robbertvdzon/pepernotenmachine/launcher/3d/trigger/pepernoten_bakje_inlaad_omhulsel.stl

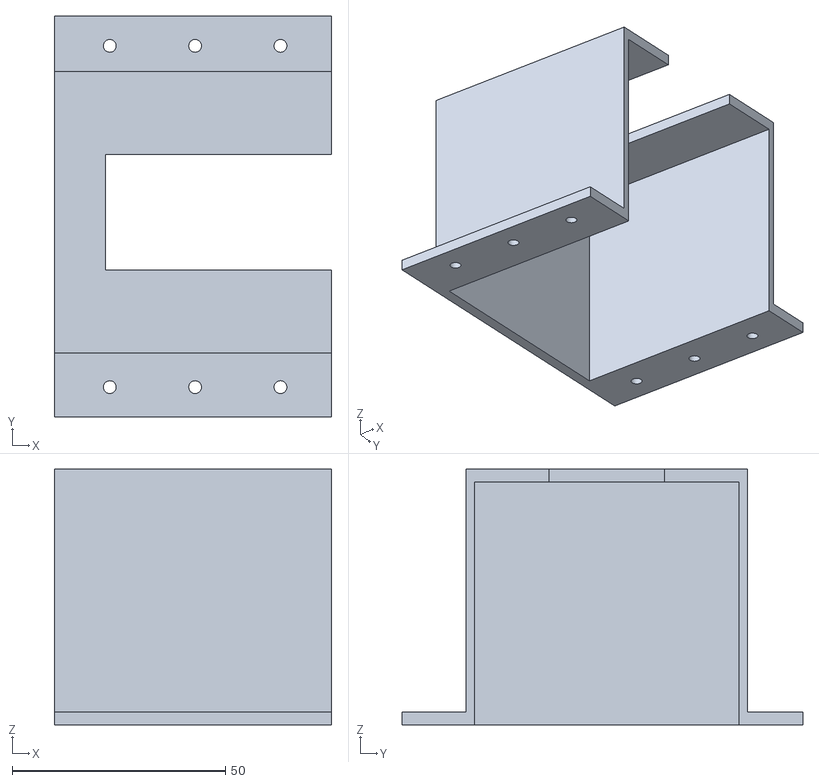
[picture p1: CAD file, 2026-10-23]
launcher/3d/trigger/pepernoten_bakje_inlaad_omhulsel.stl
65.0 x 94.0 x 60.0
