robbertvdzon/pepernotenmachine/launcher/3d/vulbak/klep_aansluiting.stl

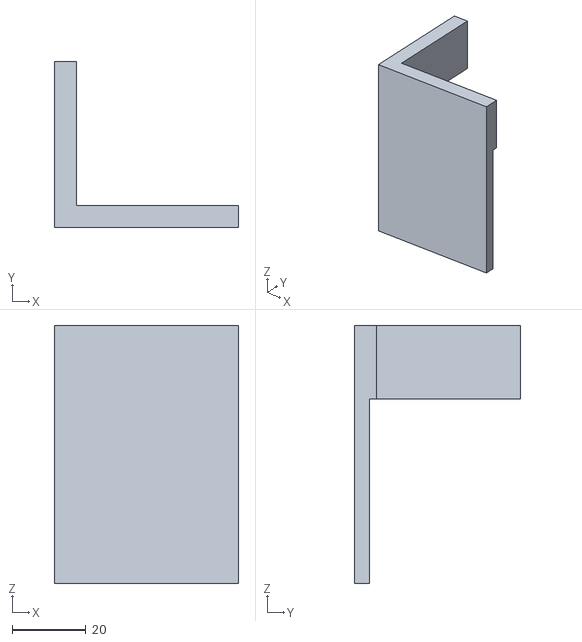
[picture p2: CAD file, 2026-10-23]
launcher/3d/vulbak/klep_aansluiting.stl
50.0 x 45.0 x 70.0
