robbertvdzon/pepernotenmachine/launcher/3d/vulbak2/balkje_op_klep.stl

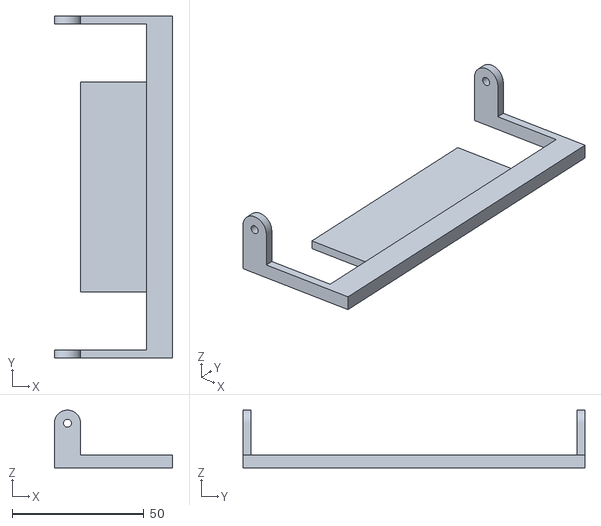
[picture p3: CAD file, 2026-10-23]
launcher/3d/vulbak2/balkje_op_klep.stl
45.0 x 130.0 x 22.0
