robbertvdzon/pepernotenmachine/motorhouder/pepernoten_motorhouder_achterkant_v2.stl

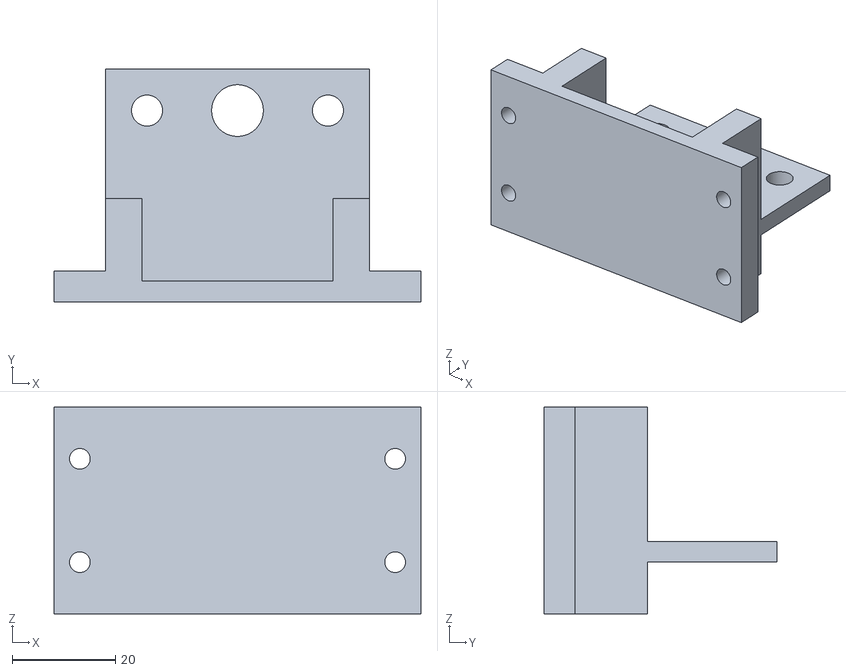
[picture p4: CAD file, 2026-10-11]
motorhouder/pepernoten_motorhouder_achterkant_v2.stl
71.0 x 45.0 x 40.0
