robbertvdzon/pepernotenmachine/launcher/3d/trigger/pepernoten_veer_houder2.stl

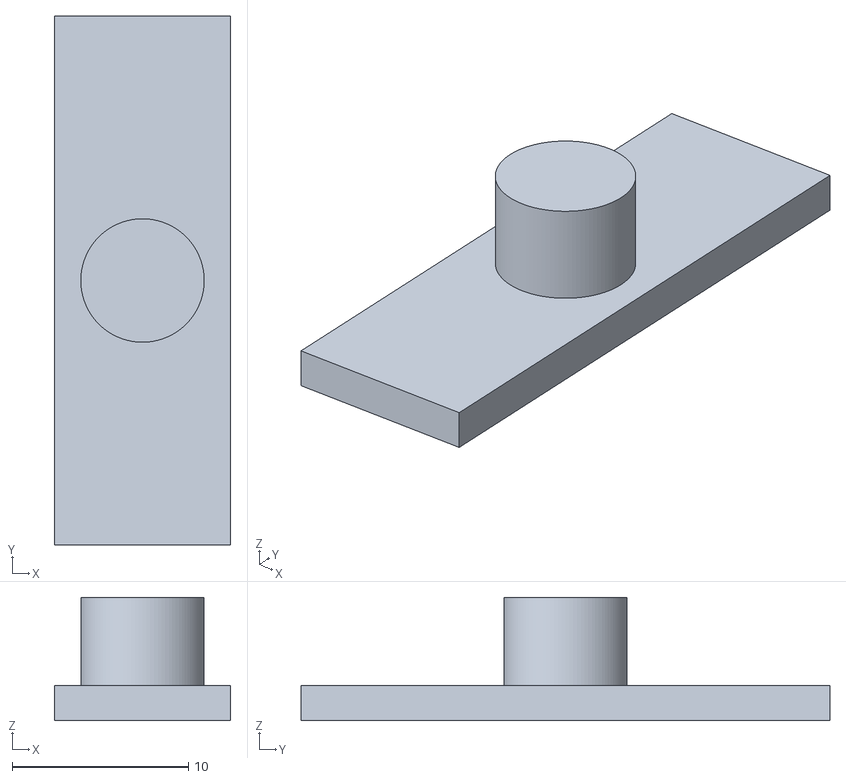
[picture p5: CAD file, 2026-09-05]
launcher/3d/trigger/pepernoten_veer_houder2.stl
10.0 x 30.0 x 7.00
