robbertvdzon/pepernotenmachine/launcher/3d/vulbak/servo_aansluiting.stl

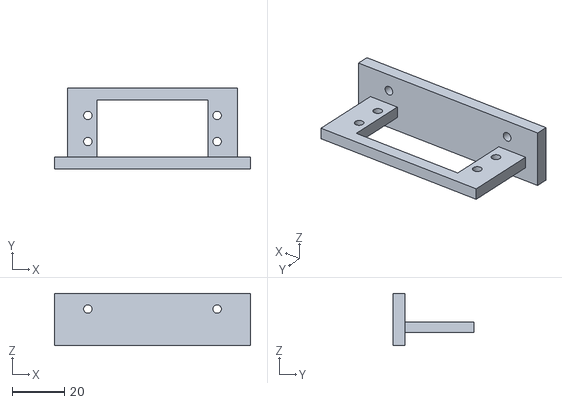
[picture p6: CAD file, 2026-10-23]
launcher/3d/vulbak/servo_aansluiting.stl
75.0 x 31.0 x 20.0
