robbertvdzon/pepernotenmachine/launcher/3d/vulbak2/trechter.stl

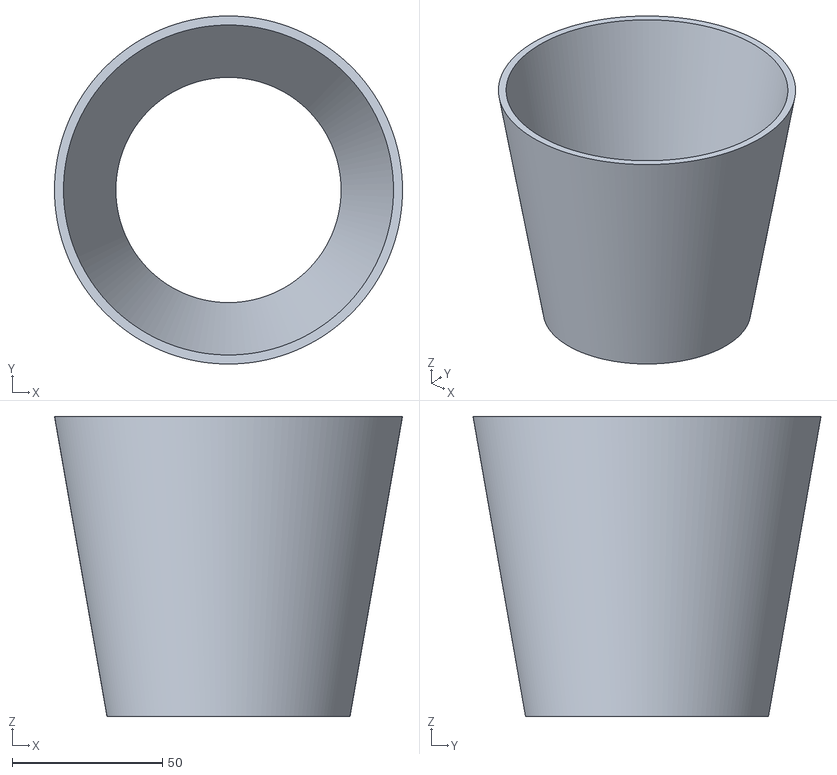
[picture p7: CAD file, 2026-10-23]
launcher/3d/vulbak2/trechter.stl
116.0 x 116.0 x 100.0
