robbertvdzon/pepernotenmachine/motorhouder/pepernoten_motoras-deksel-bovenkant.stl

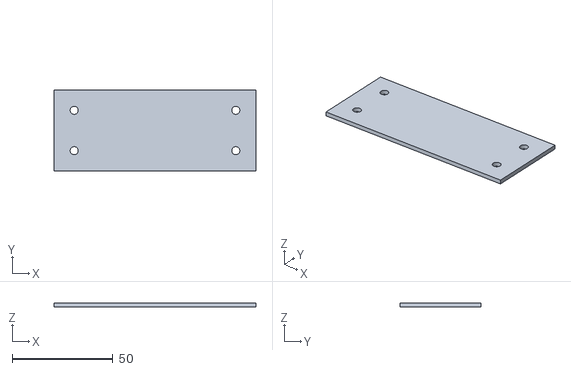
[picture p8: CAD file, 2026-09-29]
motorhouder/pepernoten_motoras-deksel-bovenkant.stl
100.0 x 40.0 x 2.00
