robbertvdzon/pepernotenmachine/launcher/3d/trigger/pepernoten_bakje_schuiver.stl

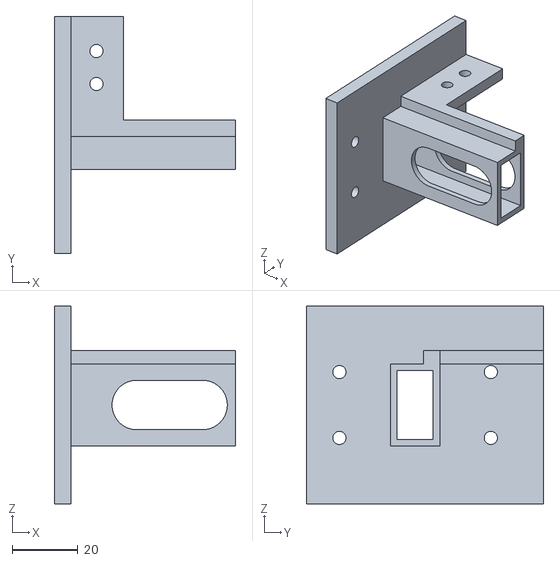
[picture p9: CAD file, 2026-09-05]
launcher/3d/trigger/pepernoten_bakje_schuiver.stl
55.0 x 72.0 x 60.0
