robbertvdzon/pepernotenmachine/motorhouder/pepernoten_motoras-deksel.stl

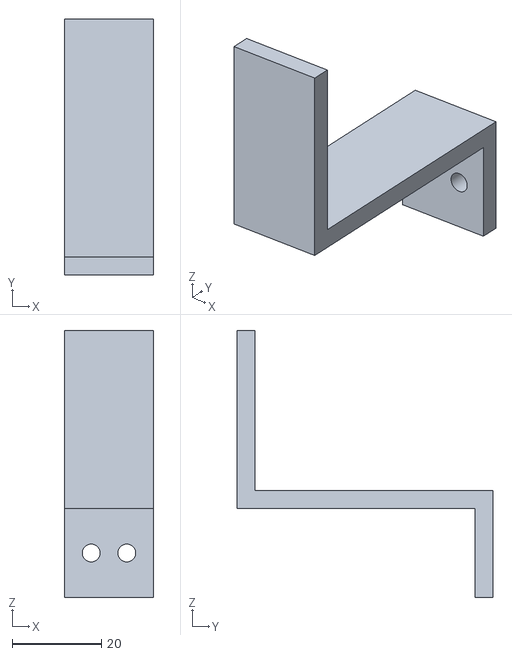
[picture p10: CAD file, 2026-09-29]
motorhouder/pepernoten_motoras-deksel.stl
20.0 x 57.5 x 60.0
