robbertvdzon/pepernotenmachine/launcher/3d/trigger/pepernoten_schakelaar_houder.stl

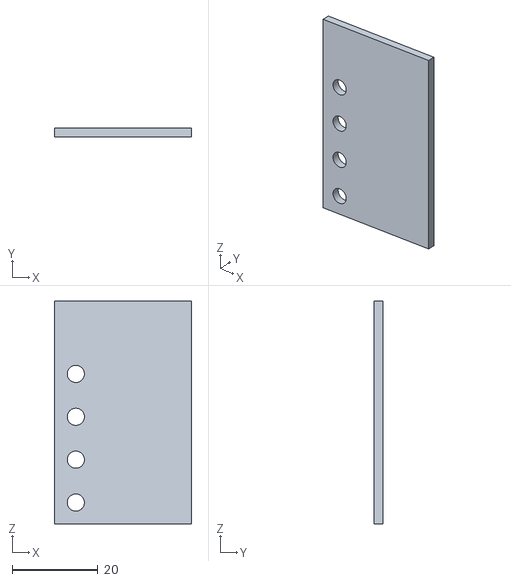
[picture p11: CAD file, 2026-09-05]
launcher/3d/trigger/pepernoten_schakelaar_houder.stl
32.0 x 2.00 x 52.0
