robbertvdzon/pepernotenmachine/launcher/3d/trigger/pepernoten_steun.stl

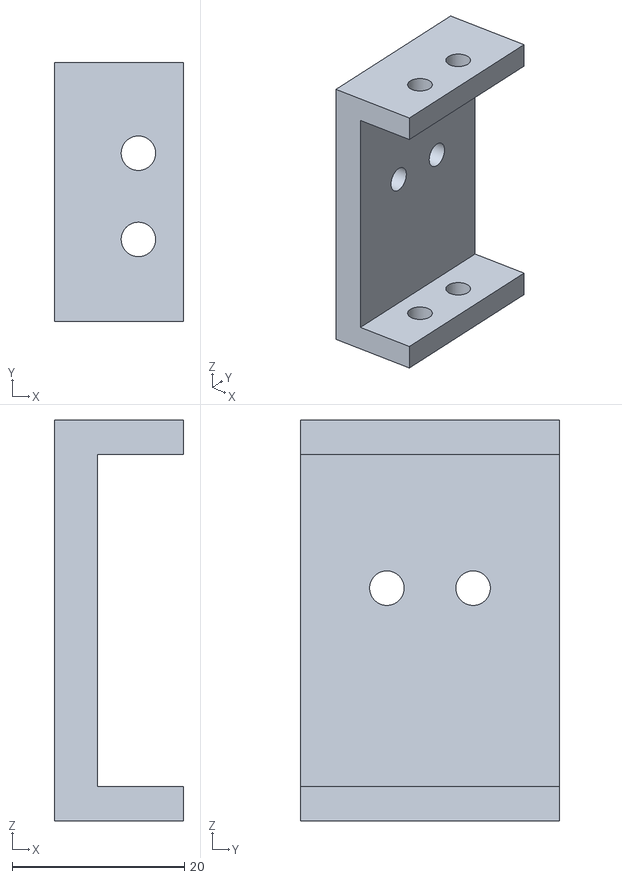
[picture p12: CAD file, 2026-09-05]
launcher/3d/trigger/pepernoten_steun.stl
15.0 x 30.0 x 46.5
