robbertvdzon/pepernotenmachine/motorhouder/pepernoten_motorhouder.stl

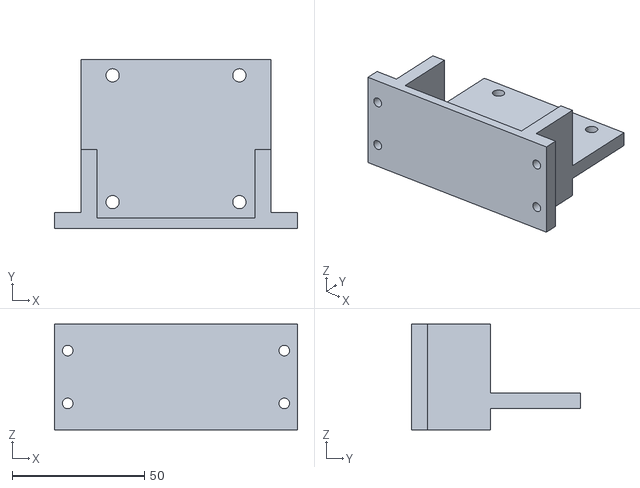
[picture p13: CAD file, 2026-09-29]
motorhouder/pepernoten_motorhouder.stl
92.0 x 64.0 x 40.0
