robbertvdzon/pepernotenmachine/launcher/3d/trigger/pepernoten_servo_aansluiting.stl

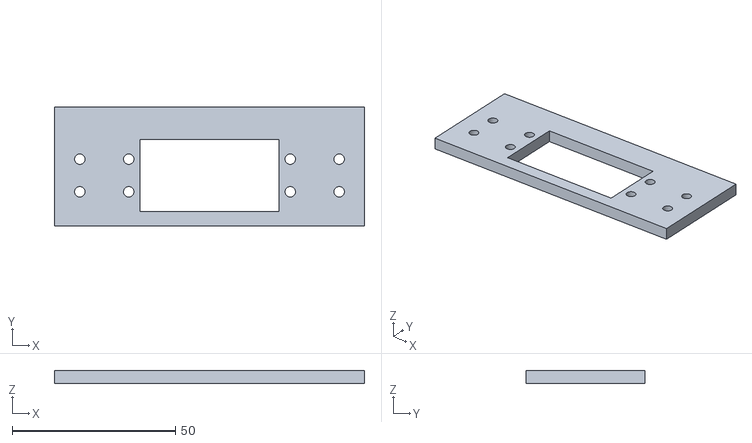
[picture p14: CAD file, 2026-09-05]
launcher/3d/trigger/pepernoten_servo_aansluiting.stl
95.0 x 36.5 x 4.00
