robbertvdzon/pepernotenmachine/motorhouder/pepernoten_motorhouder_ring.stl

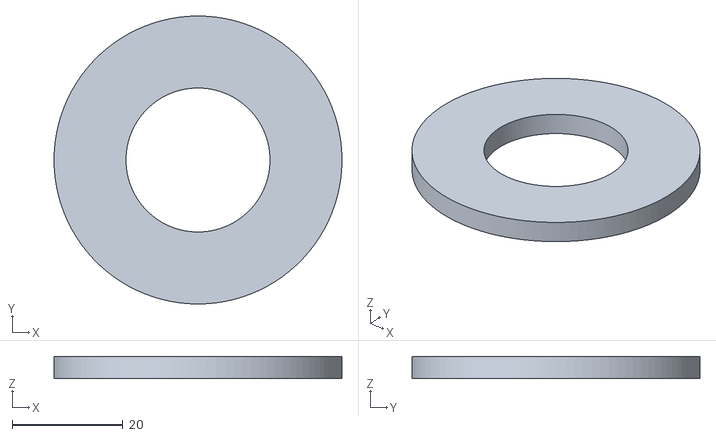
[picture p15: CAD file, 2026-09-25]
motorhouder/pepernoten_motorhouder_ring.stl
52.0 x 52.0 x 4.00
