robbertvdzon/pepernotenmachine/launcher/3d/trigger/pepernoten_veer_houder.stl

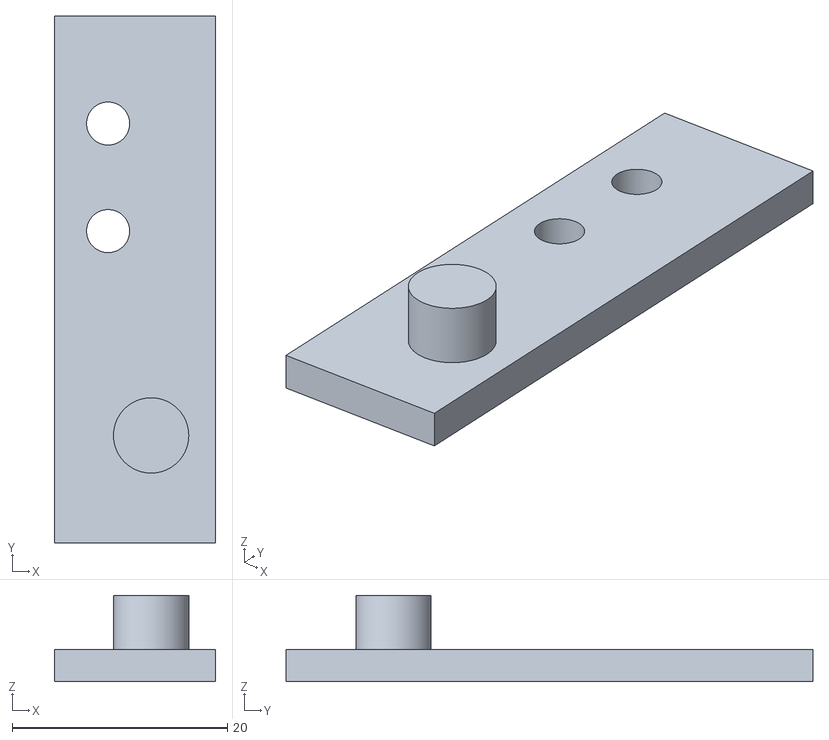
[picture p16: CAD file, 2026-09-05]
launcher/3d/trigger/pepernoten_veer_houder.stl
15.0 x 49.0 x 8.00
