robbertvdzon/pepernotenmachine/motorhouder/pepernoten_motorhouder_v2.3mf

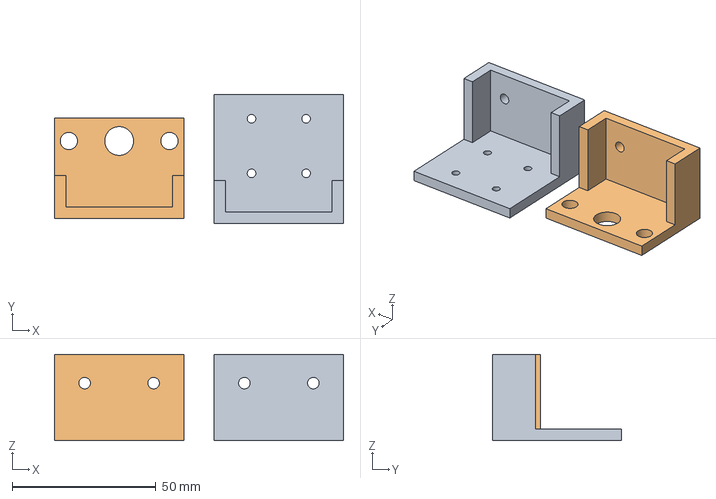
[picture p17: CAD file, 2026-09-09]
motorhouder/pepernoten_motorhouder_v2.3mf
100.6 x 45.0 x 30.0 mm
pepernoten_motorhouder_v2.stl
pepernoten_motorhouder_achterkant_v2.stl
