robbertvdzon/pepernotenmachine/launcher/3d/trigger/pepernoten_bakje_punt.stl

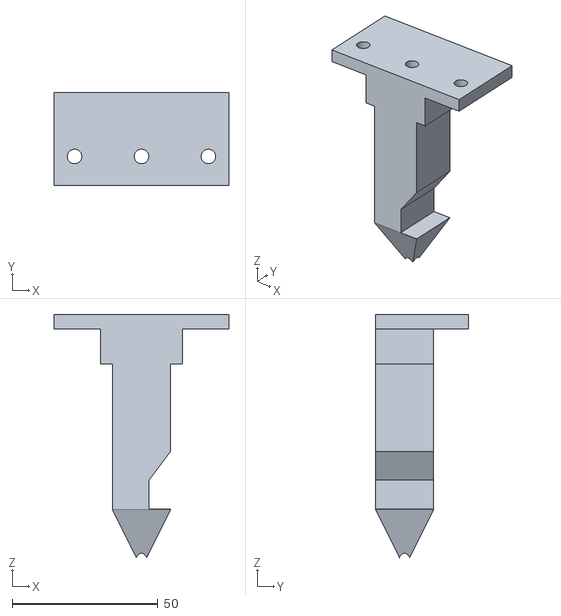
[picture p18: CAD file, 2026-09-05]
launcher/3d/trigger/pepernoten_bakje_punt.stl
60.0 x 32.0 x 83.5
