robbertvdzon/pepernotenmachine/launcher/3d/trigger/pepernoten_bakje_inlaad.stl

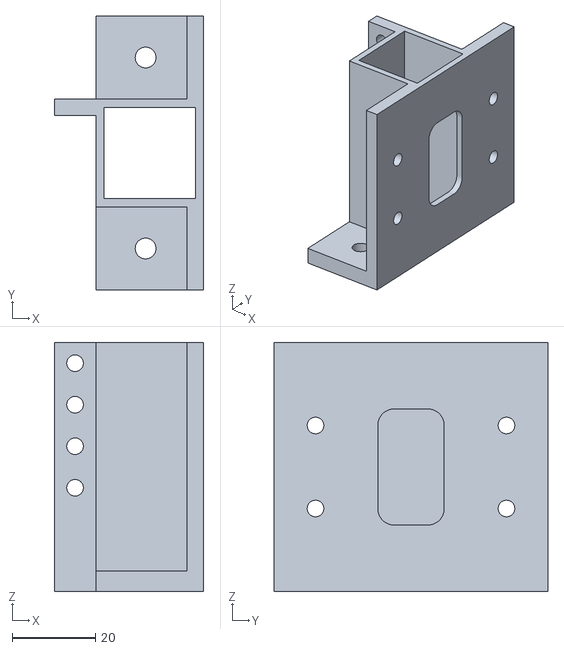
[picture p19: CAD file, 2026-09-05]
launcher/3d/trigger/pepernoten_bakje_inlaad.stl
36.0 x 66.0 x 60.0
