robbertvdzon/pepernotenmachine/launcher/3d/trigger/pepernoten_bakje_schuifas.stl

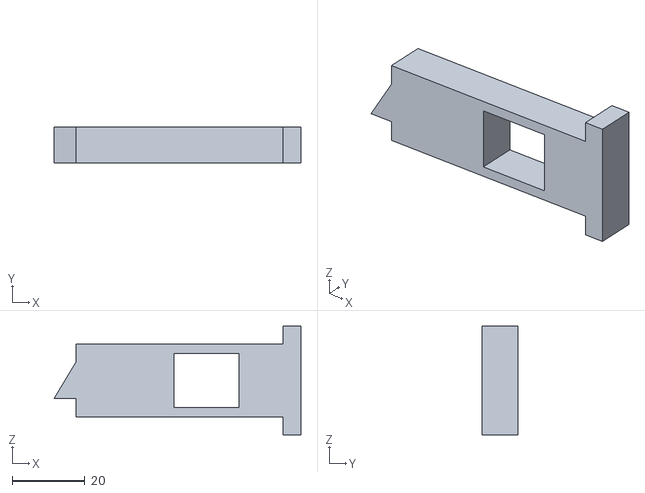
[picture p20: CAD file, 2026-09-05]
launcher/3d/trigger/pepernoten_bakje_schuifas.stl
68.0 x 10.0 x 30.0
