robbertvdzon/pepernotenmachine/launcher/3d/trigger/pepernoten_veer_houder2.scad

difference() {
union() {

    translate([-5, -15,0])
        cube([10, 30, 2]);

 translate([0,0,0]){
      rotate([0,0,0]){
           cylinder(h=7, r=3.5, $fn=100, center=false);
      }
  }
    
}


}
