robbertvdzon/pepernotenmachine/launcher/3d/vulbak/klep_aansluiting.scad

difference() {
union() {

    translate([0, 0, 0])
        cube([6, 45, 20]);
    translate([0, 0, -50])
        cube([50, 4, 70]);
    translate([0, 0, 0])
        cube([50, 6, 20]);


}






}
