robbertvdzon/pepernotenmachine/launcher/3d/vulbak/ronde_klep.scad

difference() {
union() {

  cylinder(h=3, r=80/2, $fn=100, center=false);
  translate([0, -40, 0])
        cube([110, 80, 3]);

}
}
