robbertvdzon/pepernotenmachine/(list of files, cad)

Other CAD files:
motorhouder/pepernoten_motorhouder_as.3mf
launcher/3d/vulbak/servo_aansluiting.scad
launcher/3d/trigger/pepernoten_schakelaar_houder.scad
motorhouder/pepernoten_motorhouder_as.stl
motorhouder/pepernoten_motorhouder_v2.stl
