robbertvdzon/pepernotenmachine/schakelbord/schakelbord/schakelbord.pdf

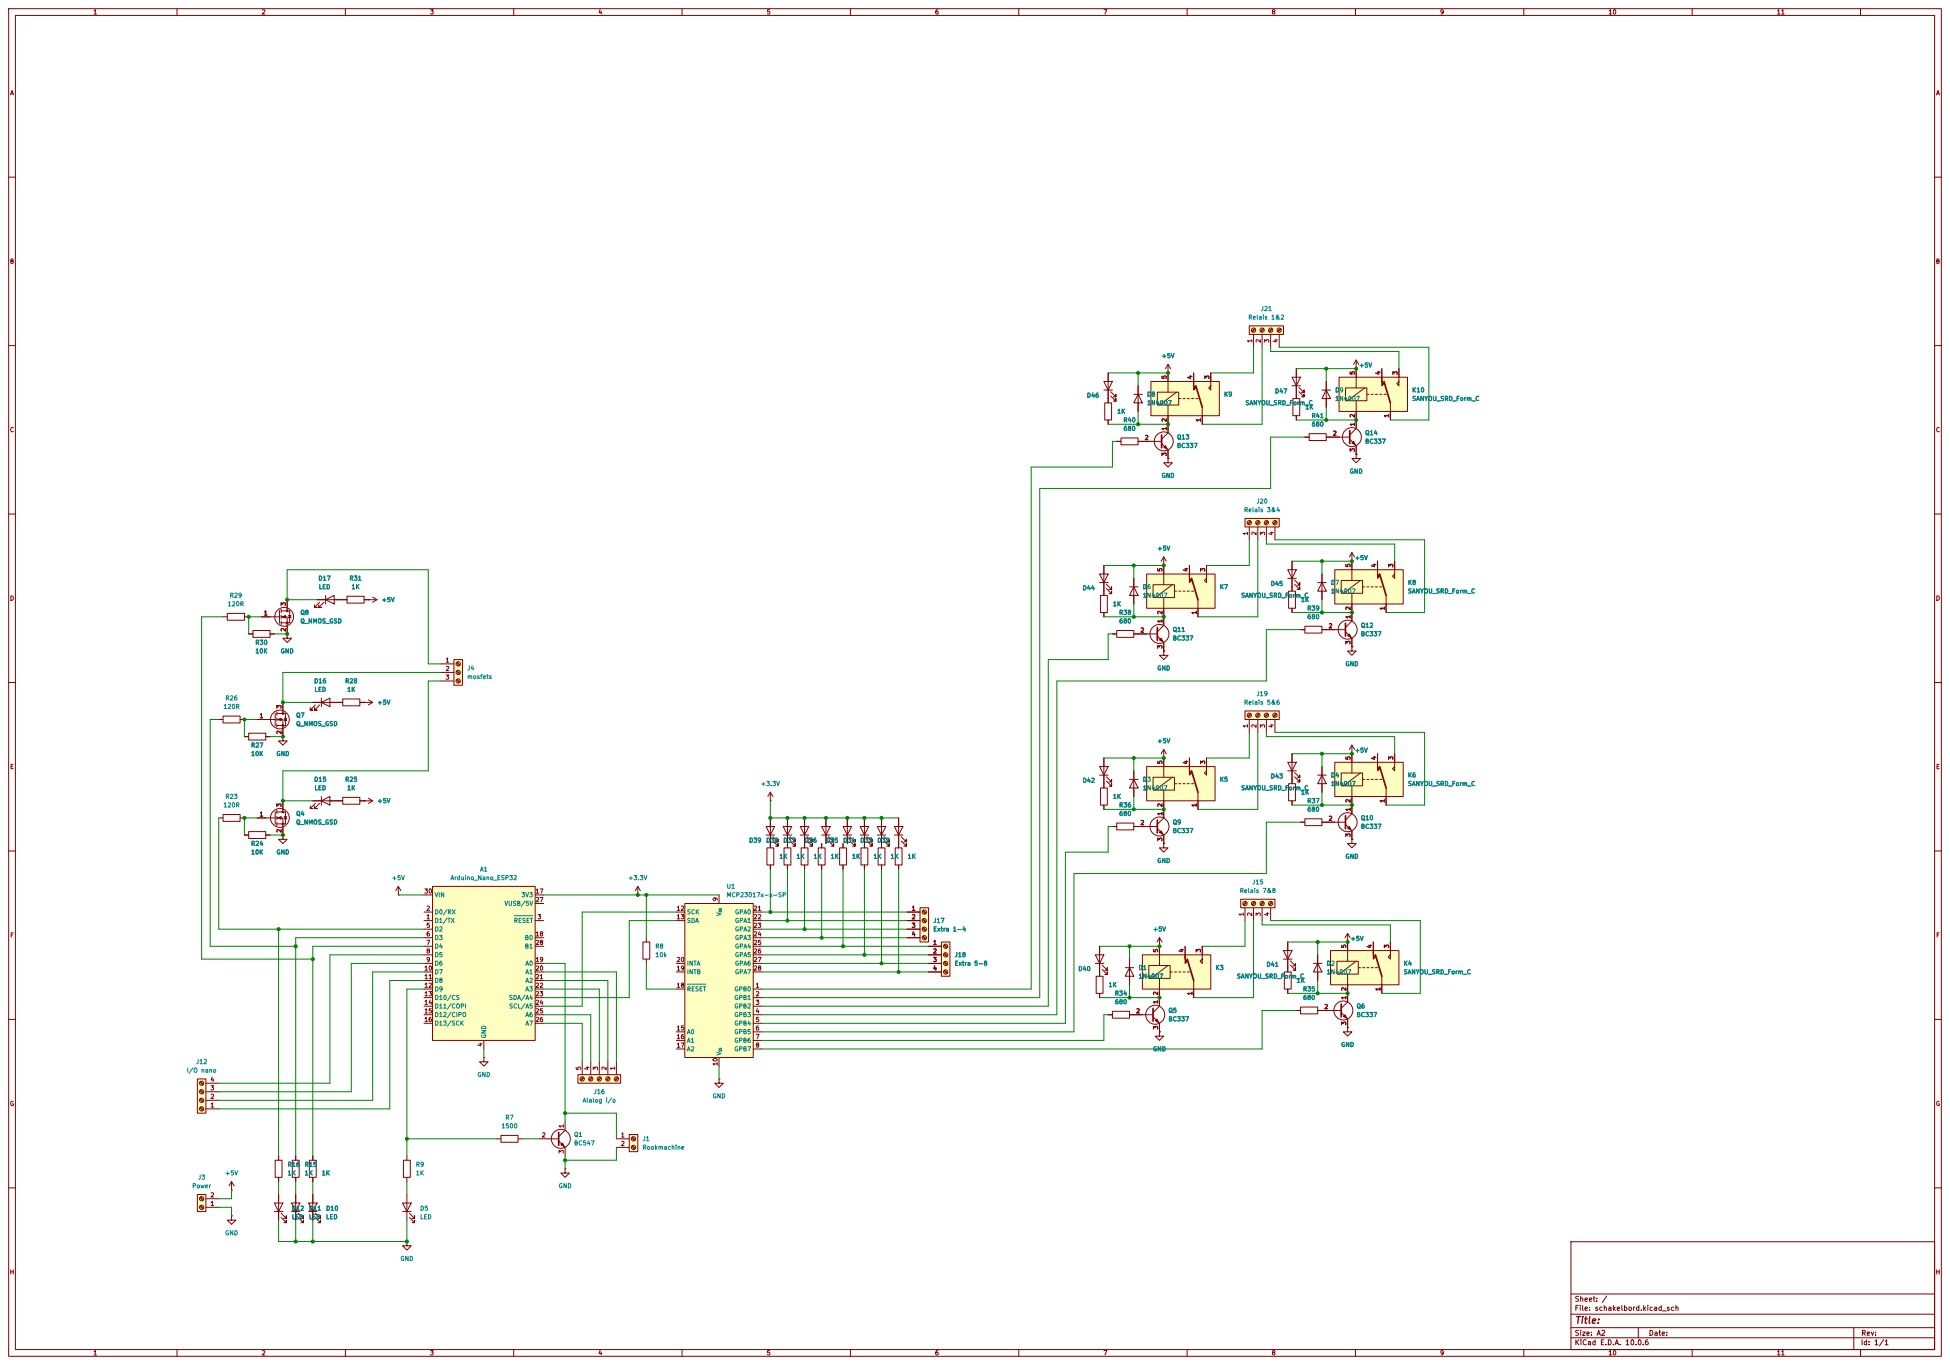
[picture p22: page 1]

SDA 13 | 2 2

4 D2 5 D3 6 D4 7 D5 8 D6 9 D7 10 D8 11 D9 12 D10/CS 13 D11/COPI 14 D12/CIPO 15 D13/SCK 16

3 3

2 2

Size: A2 | Rev:
KiCad E.D.A. 10.0.6 | Id: 1/1
