robbertvdzon/pepernotenmachine/schakelbord/schakelbord/schakelbord.kicad_pcb

## KiCad design schakelbord/schakelbord/schakelbord.kicad_pcb (2026-10-02)

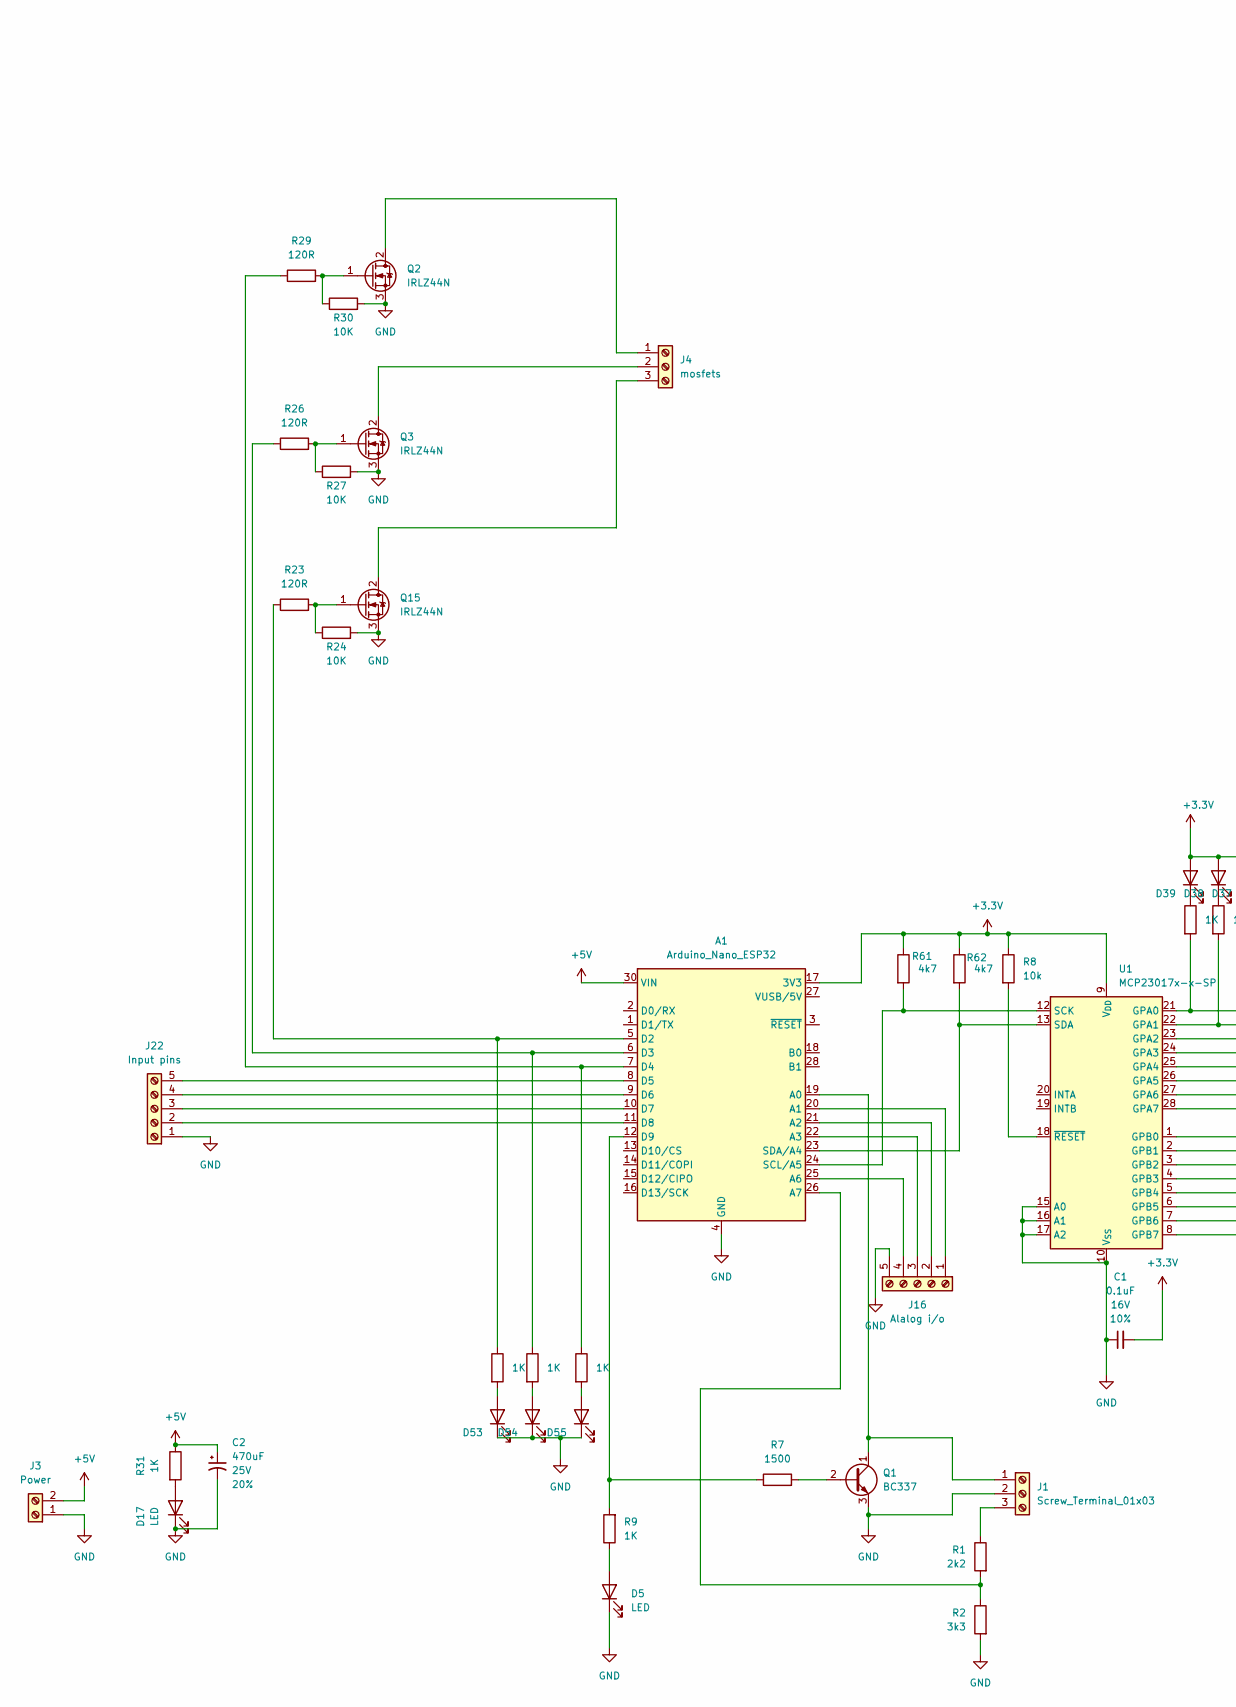
[picture p23: schematic schakelbord.kicad_sch, part in row 1, column 1]

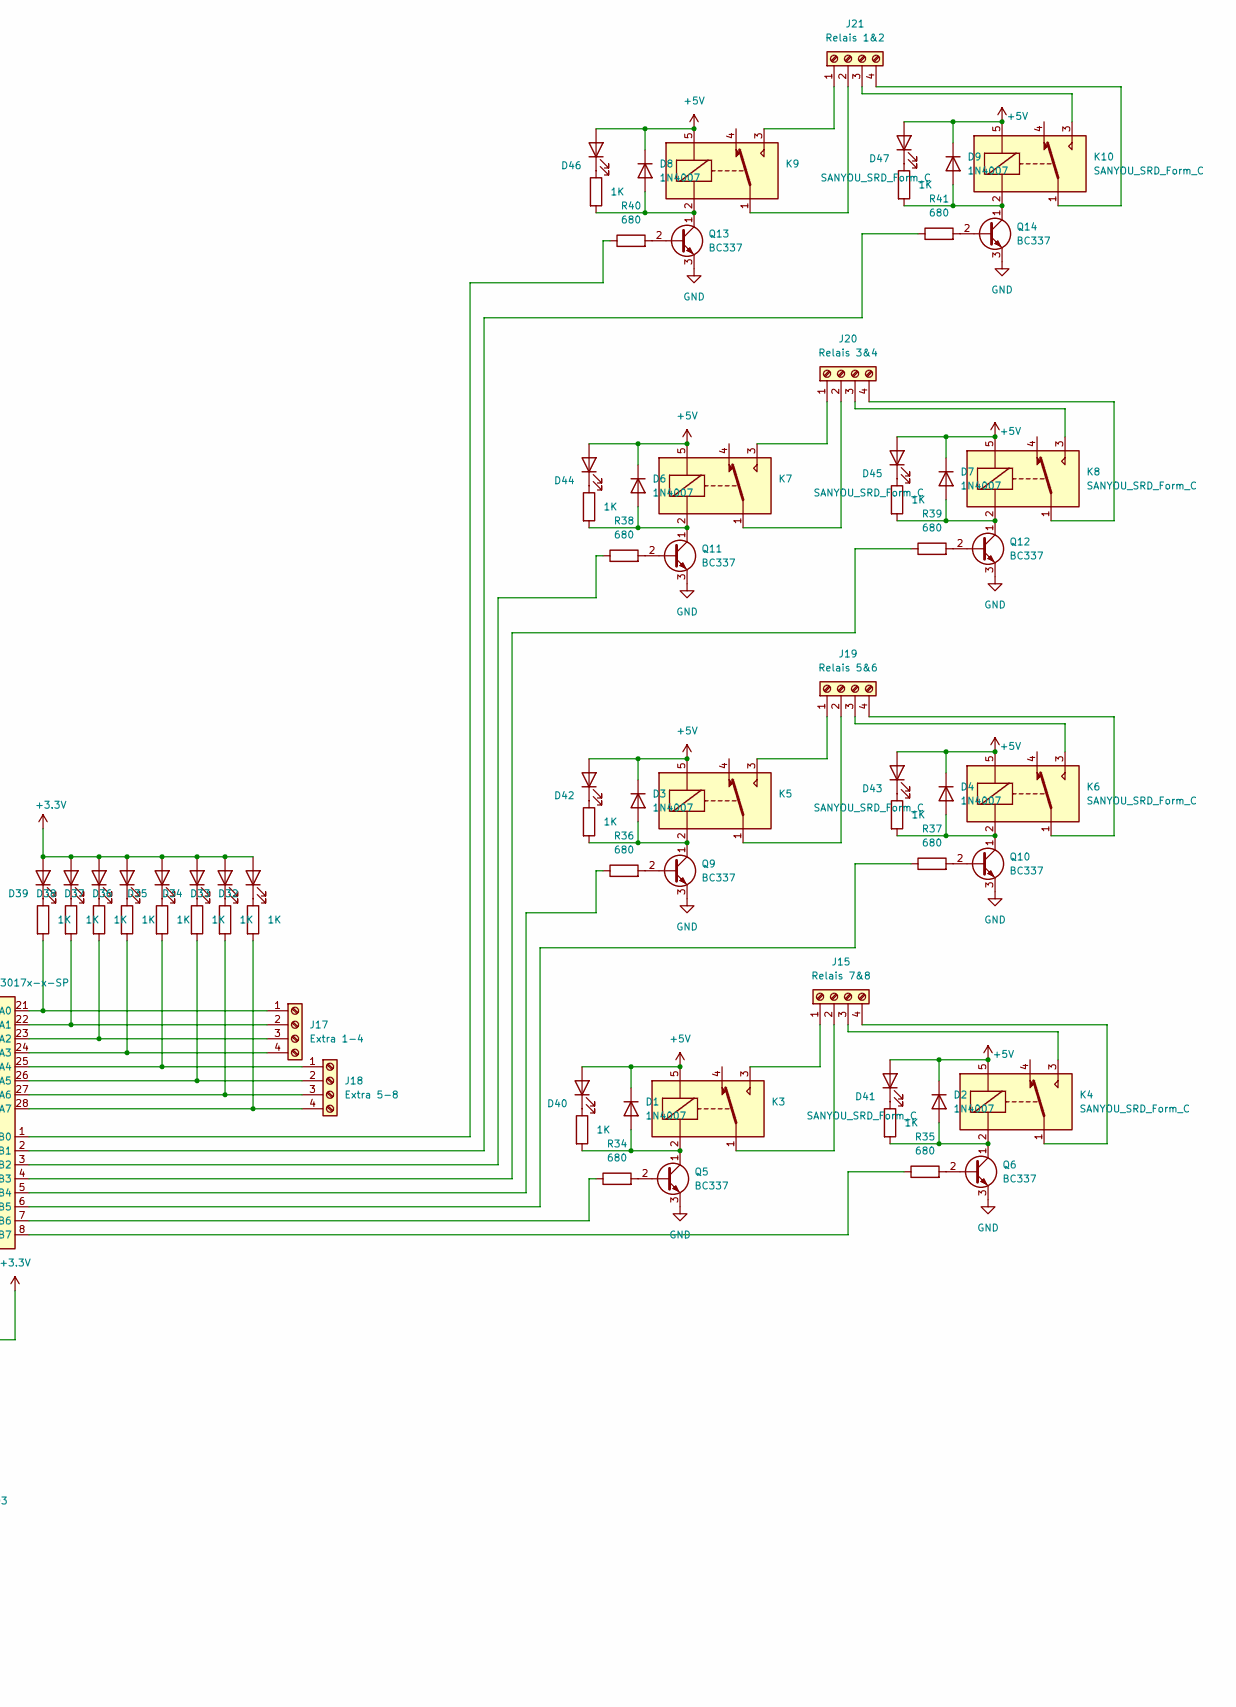
[picture p24: schematic schakelbord.kicad_sch, part in row 1, column 2]

Parts:
A1: Arduino_Nano_ESP32; Arduino_Nano
C1: 0.1uF; C_Disc_D3.0mm_W1.6mm_P2.50mm; Voltage 16V; Tolerance 10%
C2: 470uF; Electrolytic_10.3x10.3mm; Voltage 25V; Tolerance 20%
D1, D2, D3, D4, D6, D7, D8, D9: 1N4007; D_DO-41_SOD81_P10.16mm_Horizontal
D5, D17, D32, D33, D34, D35, D36, D37, D38, D39, D40, D41, D42, D43, D44, D45, D46, D47, D53, D54, D55: LED; LED_D5.0mm
J1: Screw_Terminal_01x03; TerminalBlock_Phoenix_MKDS-1,5-3-5.08_1x03_P5.08mm_Horizont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
J3: Power; TerminalBlock_Phoenix_MKDS-1,5-2-5.08_1x02_P5.08mm_Horizont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
J4: mosfets; TerminalBlock_Phoenix_MKDS-1,5-3_1x03_P5.00mm_Horizontal
J15: Relais 7&8; TerminalBlock_Phoenix_MKDS-1,5-4-5.08_1x04_P5.08mm_Horizont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
J16: Alalog i/o; TerminalBlock_Phoenix_MKDS-1,5-5-5.08_1x05_P5.08mm_Horizont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
J17: Extra 1-4; TerminalBlock_Phoenix_MKDS-1,5-4-5.08_1x04_P5.08mm_Horizont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
J18: Extra 5-8; TerminalBlock_Phoenix_MKDS-1,5-4-5.08_1x04_P5.08mm_Horizont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
J19: Relais 5&6; TerminalBlock_Phoenix_MKDS-1,5-4-5.08_1x04_P5.08mm_Horizont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
J20: Relais 3&4; TerminalBlock_Phoenix_MKDS-1,5-4-5.08_1x04_P5.08mm_Horizont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
J21: Relais 1&2; TerminalBlock_Phoenix_MKDS-1,5-4-5.08_1x04_P5.08mm_Horizont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
J22: Input pins; TerminalBlock_Phoenix_MKDS-1,5-5-5.08_1x05_P5.08mm_Horizont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
K3, K4, K5, K6, K7, K8, K9, K10: SANYOU_SRD_Form_C; Relay_SPDT_SANYOU_SRD_Series_Form_C
Q1, Q5, Q6, Q9, Q10, Q11, Q12, Q13, Q14: BC337; TO-92_Inline
Q2, Q3, Q15: IRLZ44N; TO-220-3_Vertical
R1: 2k2; R_Axial_DIN0204_L3.6mm_D1.6mm_P7.62mm_Horizontal
R2: 3k3; R_Axial_DIN0204_L3.6mm_D1.6mm_P7.62mm_Horizontal
R7: 1500; R_Axial_DIN0204_L3.6mm_D1.6mm_P7.62mm_Horizontal
R8: 10k; R_Axial_DIN0204_L3.6mm_D1.6mm_P7.62mm_Horizontal
R9: 1K; R_Axial_DIN0207_L6.3mm_D2.5mm_P10.16mm_Horizontal
R23, R26, R29: 120R; R_Axial_DIN0204_L3.6mm_D1.6mm_P7.62mm_Horizontal
R24, R27, R30: 10K; R_Axial_DIN0204_L3.6mm_D1.6mm_P7.62mm_Horizontal
R31, R44, R45, R46, R47, R48, R49, R50, R51, R52, R53, R54, R55, R56, R57, R58, R59, R67, R68, R69: 1K; R_Axial_DIN0204_L3.6mm_D1.6mm_P7.62mm_Horizontal
R34, R35, R36, R37, R38, R39, R40, R41: 680; R_Axial_DIN0204_L3.6mm_D1.6mm_P7.62mm_Horizontal
R61, R62: 4k7; R_Axial_DIN0204_L3.6mm_D1.6mm_P7.62mm_Horizontal
U1: MCP23017x-x-SP; DIP-28_W7.62mm

Connections:
+3.3V: A1.17 (3V3), C1.2, D32.2 (A), D33.2 (A), D34.2 (A), D35.2 (A), D36.2 (A), D37.2 (A), D38.2 (A), D39.2 (A), R8.1, R61.1, R62.1, U1.9 (V_{DD})
+5V: A1.30 (VIN), C2.1, D1.1 (K), D2.1 (K), D3.1 (K), D4.1 (K), D6.1 (K), D7.1 (K), D8.1 (K), D9.1 (K), D40.2 (A), D41.2 (A), D42.2 (A), D43.2 (A), D44.2 (A), D45.2 (A), D46.2 (A), D47.2 (A), J3.2, K3.5, K4.5, K5.5, K6.5, K7.5, K8.5, K9.5, K10.5, R31.1
GND: A1.4 (GND), A1.29 (GND), C1.1, C2.2, D5.1 (K), D17.1 (K), D53.1 (K), D54.1 (K), D55.1 (K), J1.2, J3.1, J16.5, J22.1, Q1.3 (E), Q2.3 (S), Q3.3 (S), Q5.3 (E), Q6.3 (E), Q9.3 (E), Q10.3 (E), Q11.3 (E), Q12.3 (E), Q13.3 (E), Q14.3 (E), Q15.3 (S), R2.2, R24.2, R27.2, R30.2, U1.10 (V_{SS}), U1.15 (A0), U1.16 (A1), U1.17 (A2)
unnamed: A1.19 (A0), J1.1, Q1.1 (C)
unnamed: A1.20 (A1), J16.1
unnamed: A1.21 (A2), J16.2
unnamed: A1.22 (A3), J16.3
unnamed: A1.25 (A6), J16.4
unnamed: A1.26 (A7), R1.2, R2.1
unnamed: A1.5 (D2), R23.1, R67.1
unnamed: A1.6 (D3), R26.1, R68.1
unnamed: A1.7 (D4), R29.1, R69.1
unnamed: A1.8 (D5), J22.5
unnamed: A1.9 (D6), J22.4
unnamed: A1.10 (D7), J22.3
unnamed: A1.11 (D8), J22.2
unnamed: A1.12 (D9), R7.1, R9.2
unnamed: A1.24 (SCL/A5), R61.2, U1.12 (SCK)
unnamed: A1.23 (SDA/A4), R62.2, U1.13 (SDA)
unnamed: D1.2 (A), K3.2, Q5.1 (C), R52.2
unnamed: D2.2 (A), K4.2, Q6.1 (C), R53.2
unnamed: D3.2 (A), K5.2, Q9.1 (C), R54.2
unnamed: D4.2 (A), K6.2, Q10.1 (C), R55.2
unnamed: D5.2 (A), R9.1
unnamed: D6.2 (A), K7.2, Q11.1 (C), R56.2
unnamed: D7.2 (A), K8.2, Q12.1 (C), R57.2
unnamed: D8.2 (A), K9.2, Q13.1 (C), R58.2
unnamed: D9.2 (A), K10.2, Q14.1 (C), R59.2
unnamed: D17.2 (A), R31.2
unnamed: D32.1 (K), R51.1
unnamed: D33.1 (K), R50.1
unnamed: D34.1 (K), R49.1
unnamed: D35.1 (K), R48.1
unnamed: D36.1 (K), R47.1
unnamed: D37.1 (K), R46.1
unnamed: D38.1 (K), R45.1
unnamed: D39.1 (K), R44.1
unnamed: D40.1 (K), R52.1
unnamed: D41.1 (K), R53.1
unnamed: D42.1 (K), R54.1
unnamed: D43.1 (K), R55.1
unnamed: D44.1 (K), R56.1
unnamed: D45.1 (K), R57.1
unnamed: D46.1 (K), R58.1
unnamed: D47.1 (K), R59.1
unnamed: D53.2 (A), R67.2
unnamed: D54.2 (A), R68.2
unnamed: D55.2 (A), R69.2
unnamed: J1.3, R1.1
unnamed: J4.1, Q2.2 (D)
unnamed: J4.2, Q3.2 (D)
unnamed: J4.3, Q15.2 (D)
unnamed: J15.1, K3.3
unnamed: J15.2, K3.1
unnamed: J15.3, K4.3
unnamed: J15.4, K4.1
unnamed: J17.1, R44.2, U1.21 (GPA0)
unnamed: J17.2, R45.2, U1.22 (GPA1)
unnamed: J17.3, R46.2, U1.23 (GPA2)
unnamed: J17.4, R47.2, U1.24 (GPA3)
unnamed: J18.1, R48.2, U1.25 (GPA4)
unnamed: J18.2, R49.2, U1.26 (GPA5)
unnamed: J18.3, R50.2, U1.27 (GPA6)
unnamed: J18.4, R51.2, U1.28 (GPA7)
unnamed: J19.1, K5.3
unnamed: J19.2, K5.1
unnamed: J19.3, K6.3
unnamed: J19.4, K6.1
unnamed: J20.1, K7.3
unnamed: J20.2, K7.1
unnamed: J20.3, K8.3
unnamed: J20.4, K8.1
unnamed: J21.1, K9.3
unnamed: J21.2, K9.1
unnamed: J21.3, K10.3
unnamed: J21.4, K10.1
unnamed: Q1.2 (B), R7.2
unnamed: Q2.1 (G), R29.2, R30.1
unnamed: Q3.1 (G), R26.2, R27.1
unnamed: Q5.2 (B), R34.2
unnamed: Q6.2 (B), R35.2
unnamed: Q9.2 (B), R36.2
unnamed: Q10.2 (B), R37.2
unnamed: Q11.2 (B), R38.2
unnamed: Q12.2 (B), R39.2
unnamed: Q13.2 (B), R40.2
unnamed: Q14.2 (B), R41.2
unnamed: Q15.1 (G), R23.2, R24.1
unnamed: R40.1, U1.1 (GPB0)
unnamed: R41.1, U1.2 (GPB1)
unnamed: R38.1, U1.3 (GPB2)
unnamed: R39.1, U1.4 (GPB3)
unnamed: R36.1, U1.5 (GPB4)
unnamed: R37.1, U1.6 (GPB5)
unnamed: R34.1, U1.7 (GPB6)
unnamed: R35.1, U1.8 (GPB7)
unnamed: R8.2, U1.18 (~RESET)

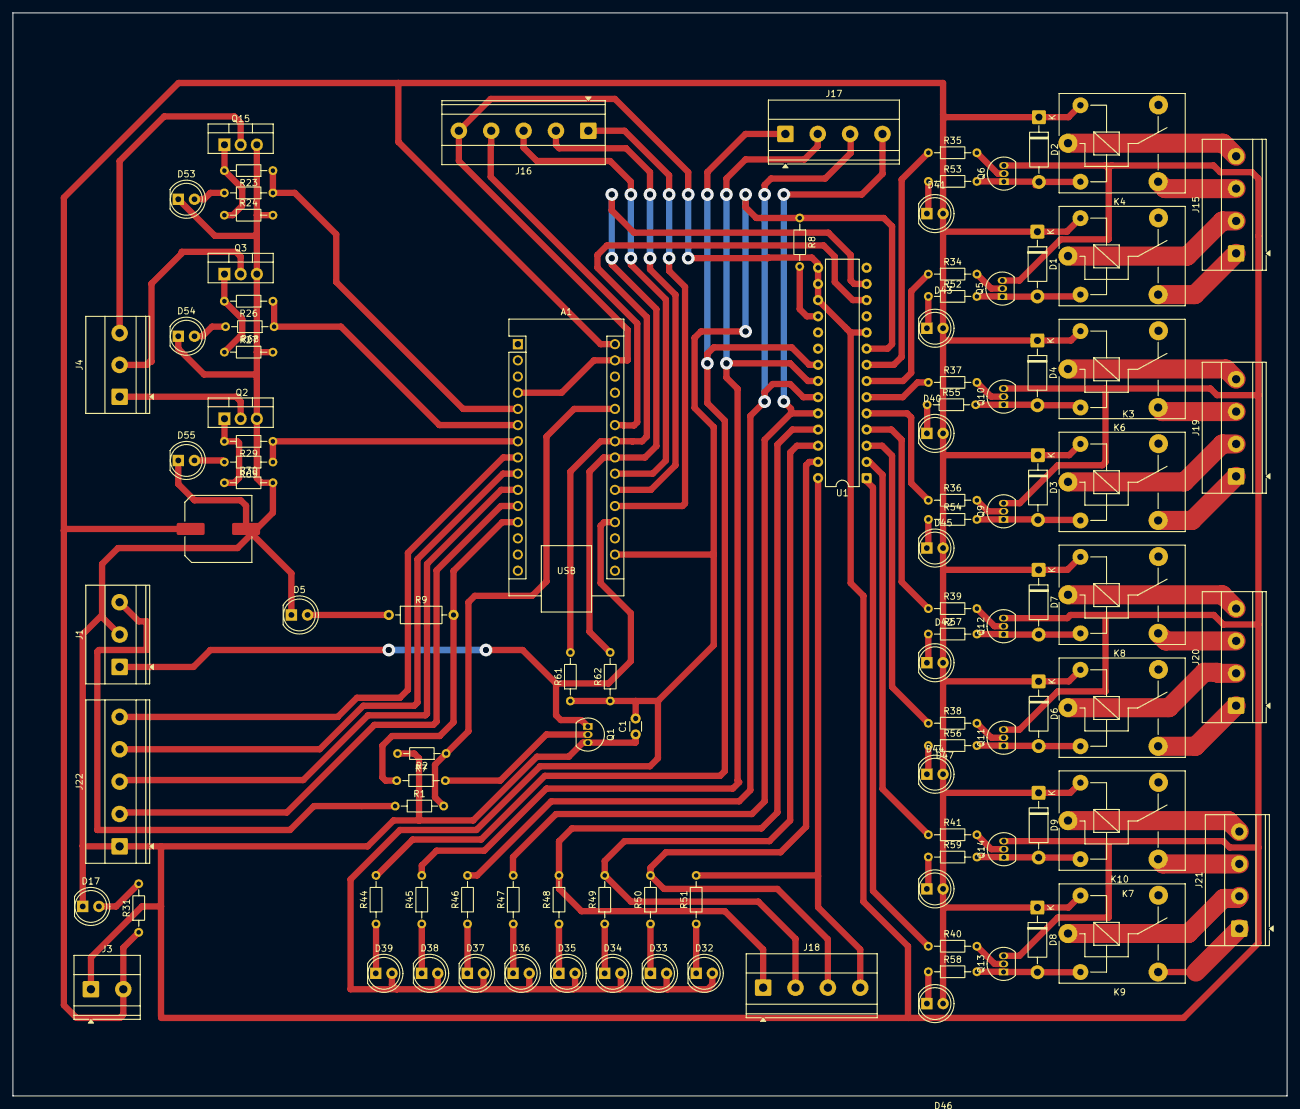
[picture p25: board schakelbord.kicad_pcb from above]

Board: 2 copper layers, 200.0 x 170.0 mm, 105 parts (0 on the bottom side), 97 nets.
