robbertvdzon/pepernotenmachine/launcher/schematics/pepermoot.kicad_pcb

## KiCad design launcher/schematics/pepermoot.kicad_pcb (2026-09-21)

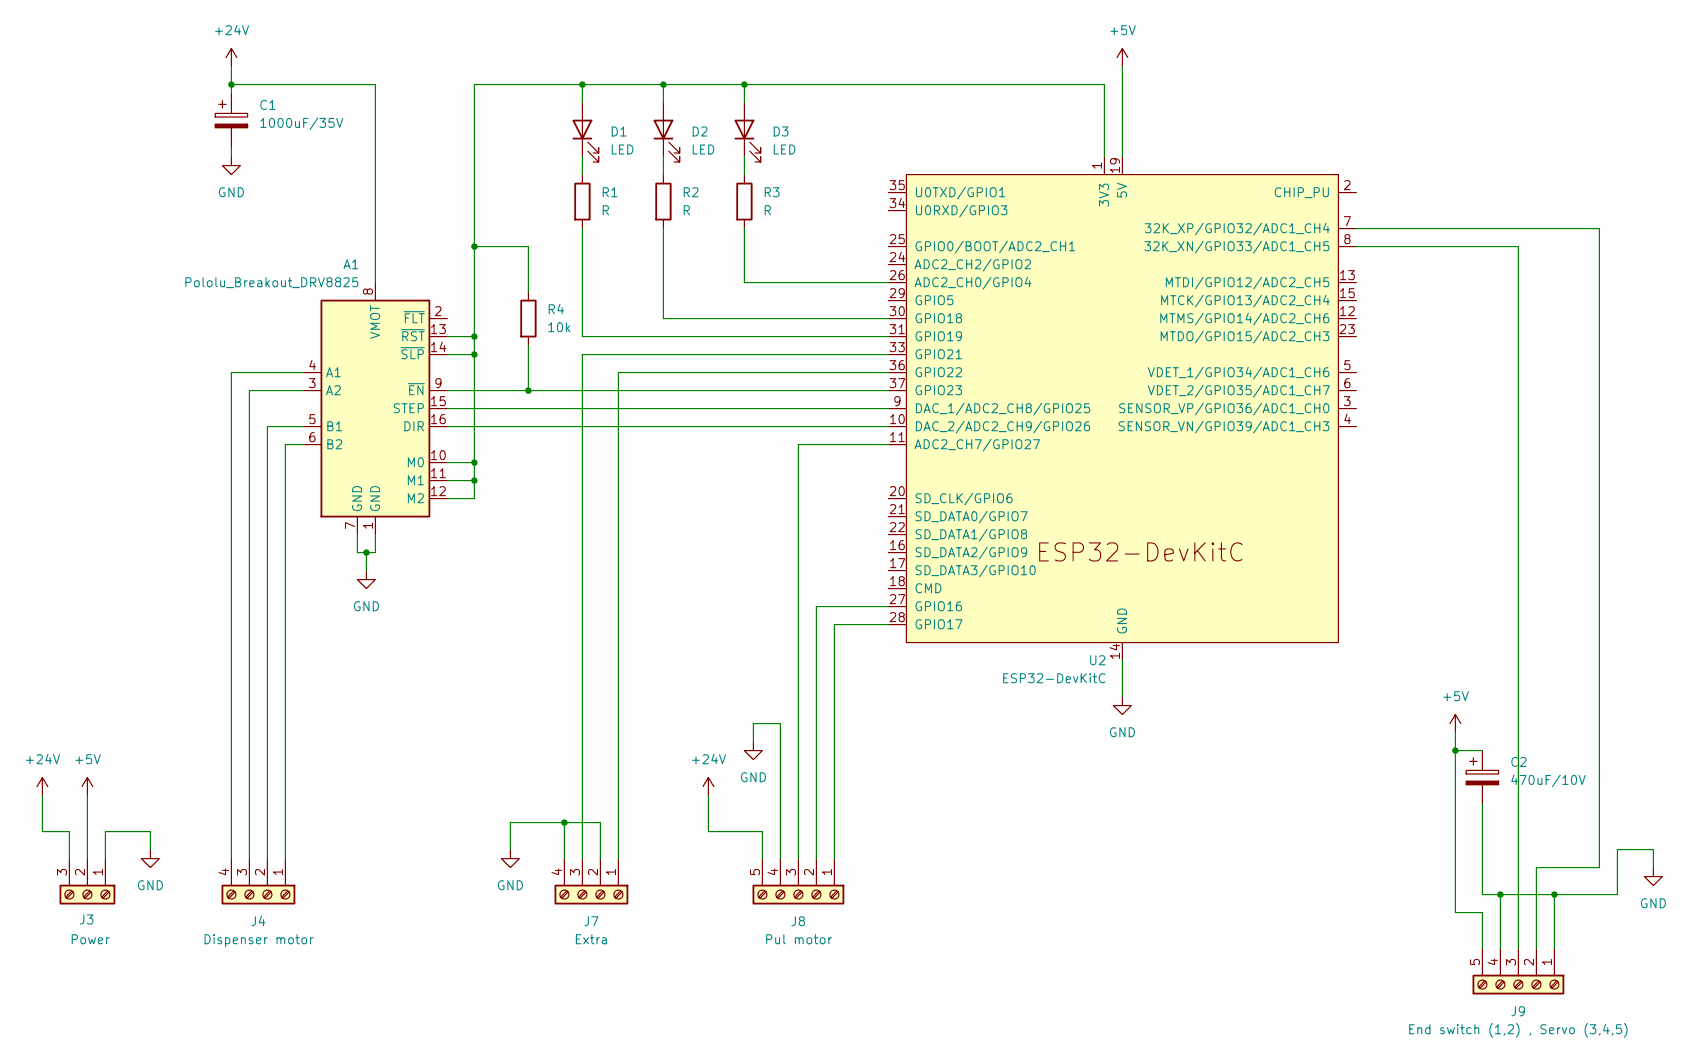
[picture p26: schematic pepermoot.kicad_sch]

Parts:
A1: Pololu_Breakout_DRV8825; Pololu_Breakout-16_15.2x20.3mm
C1: 1000uF/35V; CP_Radial_D10.0mm_P5.00mm
C2: 470uF/10V; CP_Radial_D10.0mm_P5.00mm
D1, D2, D3: LED; LED_D5.0mm
J3: Power; TerminalBlock_Phoenix_MKDS-1,5-3-5.08_1x03_P5.08mm_Horizont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
J4: Dispenser motor; TerminalBlock_Phoenix_MKDS-1,5-4-5.08_1x04_P5.08mm_Horizont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
J7: Extra; TerminalBlock_Phoenix_MKDS-1,5-4-5.08_1x04_P5.08mm_Horizont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
J8: Pul motor; TerminalBlock_Phoenix_MKDS-1,5-5-5.08_1x05_P5.08mm_Horizont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
J9: End switch (1,2) , Servo (3,4,5); TerminalBlock_Phoenix_MKDS-1,5-5-5.08_1x05_P5.08mm_Horizont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
R1, R2, R3: R; R_Axial_DIN0207_L6.3mm_D2.5mm_P10.16mm_Horizontal
R4: 10k; R_Axial_DIN0204_L3.6mm_D1.6mm_P7.62mm_Horizontal
U2: ESP32-DevKitC

Connections:
+5V: C2.1, J3.2, J9.5, U2.19 (5V)
+24V: A1.8 (VMOT), C1.1, J3.3, J8.5
GND: A1.1 (GND), A1.7 (GND), C1.2, C2.2, J3.1, J7.2, J7.4, J8.4, J9.1, J9.4, U2.14 (GND), U2.32 (GND), U2.38 (GND)
unnamed: A1.4 (A1), J4.4
unnamed: A1.3 (A2), J4.3
unnamed: A1.5 (B1), J4.2
unnamed: A1.6 (B2), J4.1
unnamed: A1.16 (DIR), U2.10 (DAC_2/ADC2_CH9/GPIO26)
unnamed: A1.10 (M0), A1.11 (M1), A1.12 (M2), A1.13 (~RST), A1.14 (~SLP), D1.2 (A), D2.2 (A), D3.2 (A), R4.1, U2.1 (3V3)
unnamed: A1.15 (STEP), U2.9 (DAC_1/ADC2_CH8/GPIO25)
unnamed: A1.9 (~EN), R4.2, U2.37 (GPIO23)
unnamed: D1.1 (K), R1.1
unnamed: D2.1 (K), R2.1
unnamed: D3.1 (K), R3.1
unnamed: J7.1, U2.36 (GPIO22)
unnamed: J7.3, U2.33 (GPIO21)
unnamed: J8.1, U2.28 (GPIO17)
unnamed: J8.2, U2.27 (GPIO16)
unnamed: J8.3, U2.11 (ADC2_CH7/GPIO27)
unnamed: J9.2, U2.7 (32K_XP/GPIO32/ADC1_CH4)
unnamed: J9.3, U2.8 (32K_XN/GPIO33/ADC1_CH5)
unnamed: R3.2, U2.26 (ADC2_CH0/GPIO4)
unnamed: R2.2, U2.30 (GPIO18)
unnamed: R1.2, U2.31 (GPIO19)

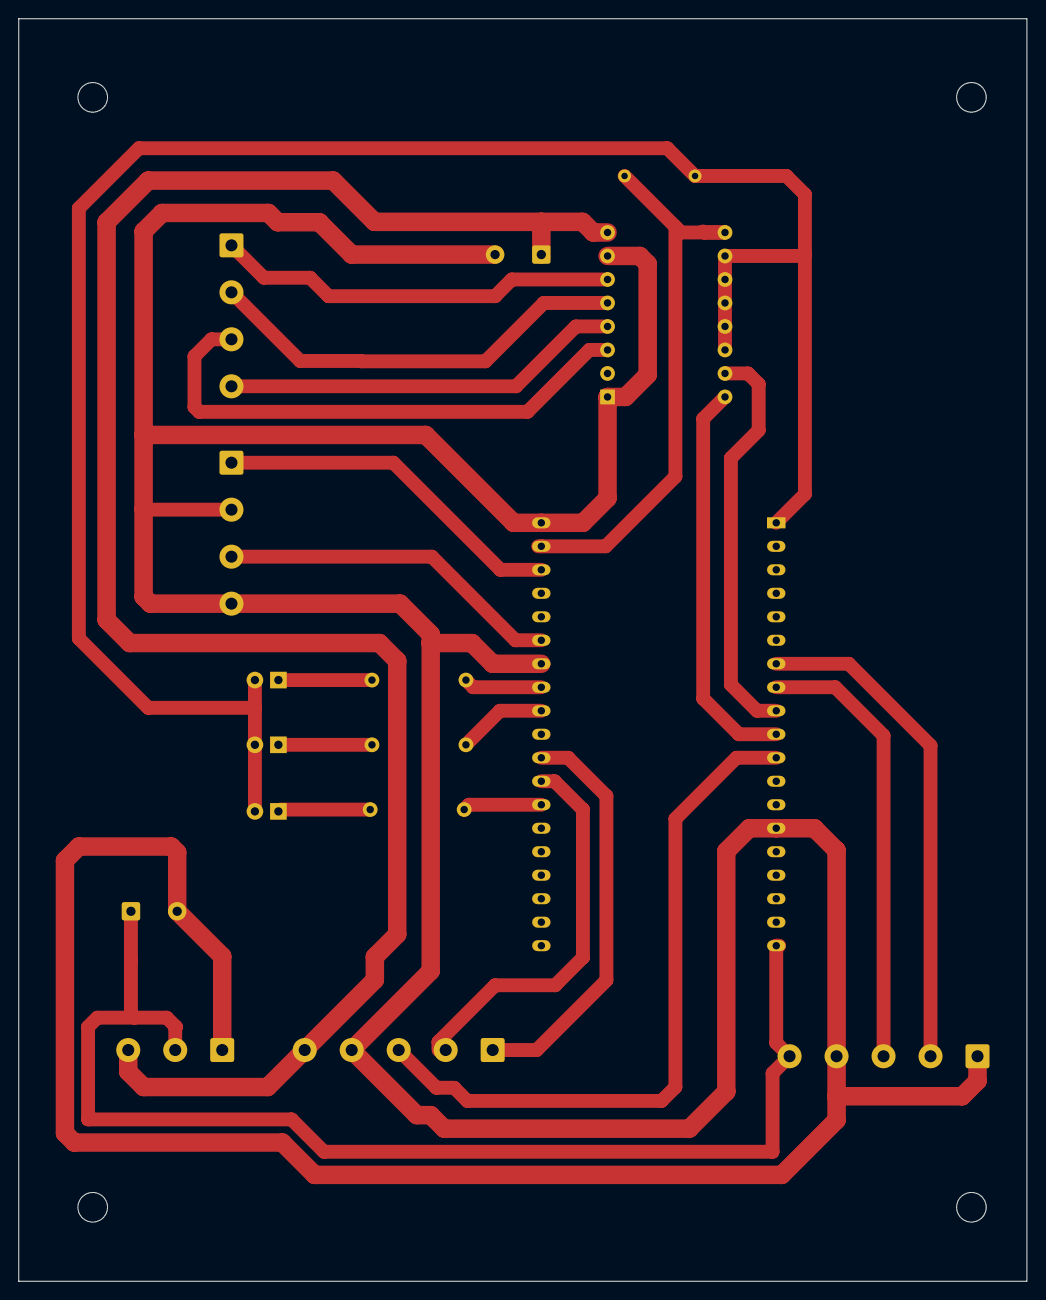
[picture p27: board pepermoot.kicad_pcb from above]

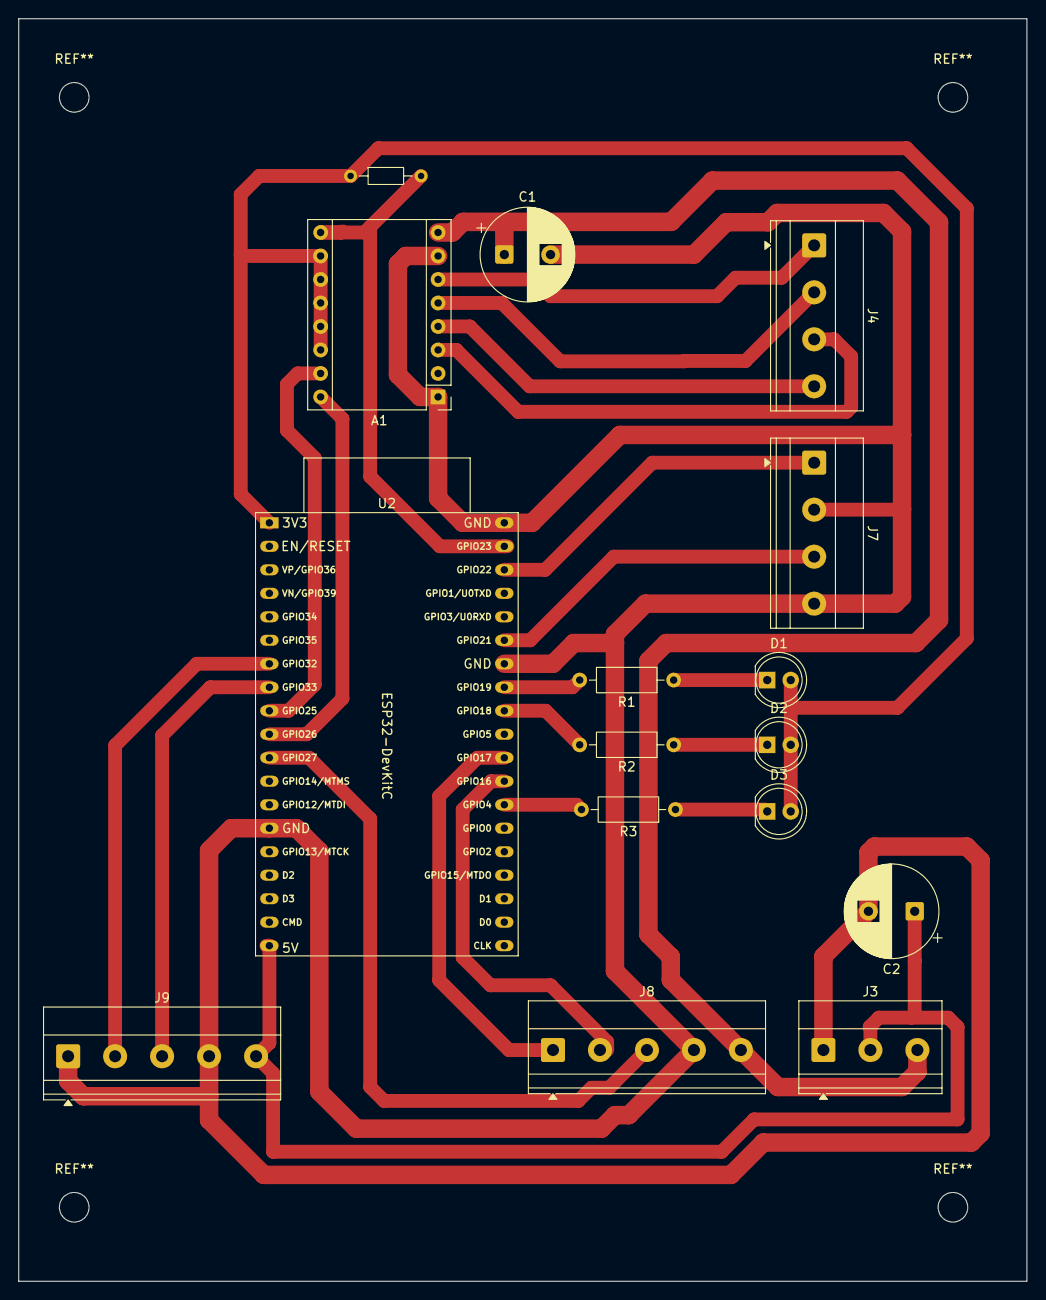
[picture p28: board pepermoot.kicad_pcb from below]

Board: 2 copper layers, 109.0 x 136.5 mm, 16 parts (16 on the bottom side), 24 nets.
