robbertvdzon/pepernotenmachine/launcher/source/include/config.h

// Common configuration: pins, UUIDs, PWM settings
#pragma once

#include <stdint.h>

static const int LED_1_PIN = 19;           // Generic indicator LED (sinking current)
static const int LED_2_PIN = 18;           // Generic indicator LED (sinking current)
static const int LED_3_PIN = 4;            // Generic indicator LED (sinking current)
static const int EXTRA_IO_1_PIN = 21;      // Not yet assigned
static const int EXTRA_IO_2_PIN = 22;      // Not yet assigned
static const int DISPENSER_EN_PIN = 23;    // Connected to EN(9) pin of DRV8825 stepper driver
static const int DISPENSER_STEP_PIN = 25;  // Connected to STEP(15) pin of DRV8825 stepper driver
static const int DISPENSER_DIR_PIN = 26;   // Connected to DIR(16) pin of DRV8825 stepper driver
static const int PULL_MOTOR_PUL_PIN = 27;  // Connected to PUL pin of MicroStep driver for pull motor
static const int PULL_MOTOR_DIR_PIN = 16;  // Connected to DIR pin of MicroStep driver for pull motor
static const int PULL_MOTOR_ENA_PIN = 17;  // Connected to ENA pin of MicroStep driver for pull motor
static const int PULL_MOTOR_END_SWITCH_PIN = 32; // Connected to end switch for pull motor (connected to GND when activated)
static const int RELEASE_SERVO_PIN = 33;  // Conected to servo for release mechanism

// BLE UUIDs
#define SERVICE_UUID "4fafc201-1fb5-459e-8fcc-c5c9c331914b"
#define PULL_MOTOR_CHARACTERISTIC_UUID "beb5483e-36e1-4688-b7f5-ea07361b26a8"
#define BUTTON_CHARACTERISTIC_UUID "beb5483e-36e1-4688-b7f5-ea07361b26aa"
#define RELEASE_SERVO_CHARACTERISTIC_UUID "beb5483e-36e1-4688-b7f5-ea07361b26ad"
#define PREPARE_LAUNCH_CHARACTERISTIC_UUID "beb5483e-36e1-4688-b7f5-ea07361b26ae"
#define DISPENSER_DURATION_CHARACTERISTIC_UUID "beb5483e-36e1-4688-b7f5-ea07361b26af"
#define DISPENSER_CONTROL_CHARACTERISTIC_UUID "beb5483e-36e1-4688-b7f5-ea07361b26b0"
#define PREPARATION_STATE_CHARACTERISTIC_UUID "beb5483e-36e1-4688-b7f5-ea07361b26b1"
#define LAUNCH_CHARACTERISTIC_UUID "beb5483e-36e1-4688-b7f5-ea07361b26b2"

// PWM (LEDC) defaults
// Motor uses channel 7 (group1 timer3) so ESP32Servo can safely allocate channel 0+.
static const int PWM_CHANNEL = 7;
static const int PWM_RESOLUTION = 8; // bits
static const int PWM_DEFAULT_DUTY = 128; // 50%

// Pull motor settings
static const int PULL_MOTOR_SPEED_MAX = 512;
static const int PULL_MOTOR_MAX_FREQ_HZ = 7200; // Hz - back to 7200 Hz for microstepping
static const int32_t PULL_MOTOR_ACCELERATION = 20000; // steps/s^2. Ramp 0 -> max speed takes 7200/20000 = 0.36 s. Lower = gentler
static const uint16_t PULL_MOTOR_DISABLE_DELAY_MS = 500; // driver stays enabled this long after the last step

// Release servo settings
static const uint8_t SERVO_MAX_ANGLE = 180;
static const uint8_t SERVO_OPEN_ANGLE = 40;
static const uint8_t SERVO_CLOSE_ANGLE = 66;

// Dispenser default settings
static const uint8_t DISPENSER_DEFAULT_DURATION = 10; // seconds
static const uint8_t DISPENSER_MAX_DURATION = 60; // seconds

// Dispenser motion control settings
static const uint16_t DISPENSER_TOP_SPEED_HZ = 2200; 
static const uint16_t DISPENSER_RAMP_TIME_MS = 2000;  // tijd om op/af te remmen naar topsnelheid

// Launcher preparation settings
static const int32_t PREPARATION_MOVE_DOWN_SPEED = 512;
static const int32_t PREPARATION_MOVE_UP_SLOW_SPEED = 128;
static const int32_t PREPARATION_MOVE_UP_FAST_SPEED = 512;
// Slow part of the way up: 2 s at slow speed = 3600 steps (was timer based)
static const uint32_t PREPARATION_MOVE_UP_SLOW_DURATION_MS = 2000;
static const uint32_t PREPARATION_MOVE_UP_SLOW_STEPS =
    (uint32_t)((uint64_t)PREPARATION_MOVE_UP_SLOW_SPEED * PULL_MOTOR_MAX_FREQ_HZ / PULL_MOTOR_SPEED_MAX *
               PREPARATION_MOVE_UP_SLOW_DURATION_MS / 1000);
// Fast part of the way up: 24 s at 7200 Hz = 172800 steps (was timer based)
static const uint32_t PREPARATION_MOVE_UP_FAST_DURATION_SEC = 23;
static const uint32_t PREPARATION_MOVE_UP_FAST_STEPS = 7200UL * PREPARATION_MOVE_UP_FAST_DURATION_SEC;
// Give up when the end switch isn't reached after this long (nominal full-speed down travel is ~25 s)
static const uint32_t PREPARATION_MOVE_DOWN_TIMEOUT_MS = 40000;
