robbertvdzon/pepernotenmachine/launcher/source/include/ble_manager.h

#pragma once
#include <stdint.h>

typedef void (*pull_motor_write_cb_t)(int32_t value);
typedef void (*release_servo_write_cb_t)(uint8_t angle);
typedef void (*prepare_write_cb_t)();
typedef void (*launch_write_cb_t)();
typedef void (*dispenser_duration_write_cb_t)(uint8_t seconds);
typedef void (*dispenser_start_write_cb_t)(uint8_t command);

void ble_init(pull_motor_write_cb_t motorCb, release_servo_write_cb_t servoCb, prepare_write_cb_t prepareCb, launch_write_cb_t launchCb, dispenser_duration_write_cb_t dispenserDurationCb, dispenser_start_write_cb_t dispenserStartCb);
bool ble_is_connected();
void ble_notify_button(uint8_t payload);
void ble_notify_pull_motor_speed(int32_t speed);
void ble_notify_servo_angle(uint8_t angle);
void ble_notify_dispenser_start(uint8_t state);
void ble_notify_preparation_state(uint8_t state);
