robbertvdzon/pepernotenmachine/(commit log)

2026-01-15 Add crossfade end indicator and add ability to control motor direction
2026-02-18 Provide linear motor speed control
2026-02-18 Make button code async
2026-02-18 Make the led code async
2026-04-10 Fix PWM timing conflict between servo and motor
2026-09-04 Add support for generic ESP32 dev board
2026-09-04 Update code to match the new PCB design (remove NeoPixel and horn control, and rewire pins)
2026-09-05 add trigger
    [pepernoten_bakje_inlaad.scad, pepernoten_bakje_inlaad.stl, pepernoten_bakje_punt.scad, pepernoten_bakje_punt.stl, pepernoten_bakje_schuifas.scad, pepernoten_bakje_schuifas.stl, pepernoten_bakje_schuiver.scad, pepernoten_bakje_schuiver.stl]
2026-09-05 Add launcher schematics
    [pepermoot.kicad_pcb, pepermoot.kicad_sch]
2026-09-05 pcb update
    [pepermoot.kicad_pcb, pepermoot.kicad_sch, pepernoten_bakje_inlaad.scad, pepernoten_bakje_inlaad.stl, pepernoten_bakje_punt.scad, pepernoten_bakje_punt.stl, pepernoten_bakje_schuifas.scad, pepernoten_bakje_schuifas.stl]
2026-09-05 Move resistor
    [pepermoot.kicad_pcb]
2026-09-06 Minor update
    [pepermoot.kicad_pcb]
2026-09-09 Fix errors in sequence code
    [button.cpp, sequence.cpp]
2026-09-11 Add support for manual launch control switch (Schaapie operated)
2026-09-11 Fix crash when setting servo angle
    [main.cpp, release_servo.cpp]
2026-09-16 Add state led to the dispenser
2026-09-16 Add state led to the rellease servo
2026-09-23 Move connector up a bit
    [pepermoot.kicad_sch]
2026-09-25 Adjust minimum and maximum servo angle
2026-09-26 Add option to detect if smoke machine is turned on
    [schakelbord.kicad_sch]
2026-09-27 Eerste opzet bedieningspaneel
    [controlpanel.kicad_pcb, controlpanel.kicad_sch]
2026-09-28 Add rotary knob
    [controlpanel.kicad_sch]
2026-10-02 Revert "Cleanup"
    This reverts commit 4277aa74836c99404227eb422add9ba860ad75b2.
    [schakelbord.kicad_sch]
2026-10-02 First version of switchboard software
2026-10-02 Change pin and connector numbers to non-normalized numbers again
2026-10-03 Fix wrong pull motor frequency calculation
    [pull_motor.cpp]
2026-10-04 Revert back to a quarter microstepping for smoother pull motor rotation
2026-10-04 Use motor speed ramping for the pull motor as well
2026-10-04 Fix button debouncing
2026-10-14 Vulbak testsoftware: servo cyclus bij D2 laag, alleen kanaal 0
2026-10-24 Make unlocking and lockiing the servo part of thje sequence
